discontentBoron/sero/(commit log)

2026-07-19 Included simulations dir
    [freq_v_length.sch, tran_sero.sch, tran_sero_pex.sch, vdd_v_freq.sch, vdd_v_freq_pex.sch]
2026-07-19 Added schematic and layout images
2026-07-19 Fixed: vdd_v_freq sweep showing incorrect values at lower values VDD
    [tran_sero.sch, tran_sero_pex.sch, vdd_v_freq.sch, vdd_v_freq_pex.sch]
2026-07-19 README.md includes schematics and layout images
